RedTempus/ATMEGA328-OLED-Watch/image.png

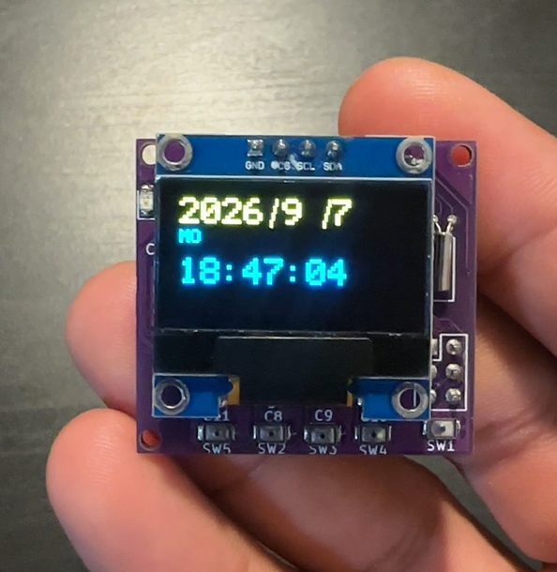
image.png
