RedTempus/ATMEGA328-OLED-Watch/watchPCB.JPG

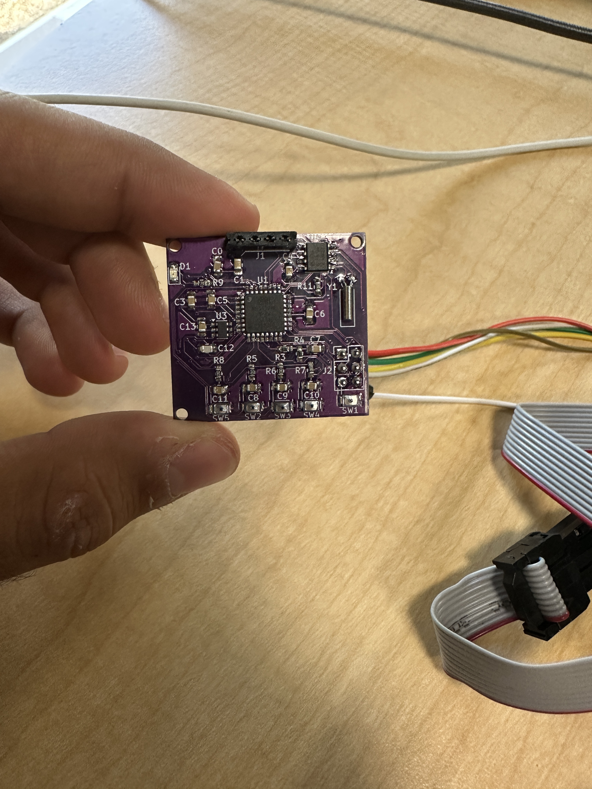
watchPCB.JPG
