RedTempus/ATMEGA328-OLED-Watch/README.md

# ATMEGA328-OLED-Watch
Building a reprogrammable watch around the ATMEGA328 microcontroller, with a OLED screen, and running it off of a CR2450 battery.
