RedTempus/ATMEGA328-OLED-Watch/BOM.xls

Sales Order #: | Web Order #: | PO Number: | Line No. | Order Date: | Order Status: | Mouser #: | Mfr. #: | Desc.: | Customer # | Order Qty. | Ext. (USD) | Price (USD) | Status | Date | Invoice # | Tariff: Price (USD) | Tariff: Ext. (USD)
280572248 | 39494410 | 39494410 | 1 | 12-Jun-26 | Complete | 556-ATMEGA328P-ANR | ATMEGA328P-ANR | 8-bit Microcontrollers - MCU 8-bit Microcontrollers - MCU AVR 32K FLSH 2K SRAM 1KB EE-20 MHZ 105C |  | 4 | $2.89 | $2.89 | 4 Shipped | 15-Jun-26 | 90869083
280572248 | 39494410 | 39494410 | 2 | 12-Jun-26 | Complete | 791-0805B104J250CT | 0805B104J250CT | Multilayer Ceramic Capacitors MLCC - SMD/SMT Multilayer Ceramic Capacitors MLCC - SMD/SMT 0805 MLCC X7R 0.1 uF, +/- 5% 25 V T&R GP |  | 100 | $0.021 | $0.021 | 100 Shipped | 15-Jun-26 | 90869083
280572248 | 39494410 | 39494410 | 3 | 12-Jun-26 | Complete | 859-LTST-C171KGKT | LTST-C171KGKT | Single Color LEDs Single Color LEDs Green Clear 571nm |  | 10 | $0.07 | $0.07 | 10 Shipped | 15-Jun-26 | 90869083 | $0.006 | $0.06
280572248 | 39494410 | 39494410 | 4 | 12-Jun-26 | Complete | 187-CL21A106KPFNNNG | CL21A106KPFNNNG | Multilayer Ceramic Capacitors MLCC - SMD/SMT Multilayer Ceramic Capacitors MLCC - SMD/SMT 10uF+/-10% 10V X5R 2 0805 |  | 25 | $0.04 | $0.04 | 25 Shipped | 15-Jun-26 | 90869083 | $0.003 | $0.08
280572248 | 39494410 | 39494410 | 5 | 12-Jun-26 | Complete | 80-C0805C102K9RACTU | C0805C102K9RACTU | Multilayer Ceramic Capacitors MLCC - SMD/SMT Multilayer Ceramic Capacitors MLCC - SMD/SMT 6.3V 0.001uF 10% X7R 0805 |  | 20 | $0.043 | $0.043 | 20 Shipped | 15-Jun-26 | 90869083 | $0.003 | $0.06
280572248 | 39494410 | 39494410 | 6 | 12-Jun-26 | Complete | 640-SWT7016006016SSA | SWT7016-006016SSA | Tactile Switches Tactile Switches Tactile Switch, SPST-NO, 3.0 x 2.0mm, Top act 0.6mm high, 160g, SMT, IP67 |  | 25 | $0.173 | $0.173 | 25 Shipped | 15-Jun-26 | 90869083 | $0.066 | $1.65
280572248 | 39494410 | 39494410 | 7 | 12-Jun-26 | Complete | 595-TPS22917DBVR | TPS22917DBVR | Power Switch ICs - Power Distribution Power Switch ICs - Power Distribution 5.5-V 2-A 80-mohm 10 -nA leakage load A A 595-TPS22917DBVT |  | 10 | $0.363 | $0.363 | 10 Shipped | 15-Jun-26 | 90869083
280572248 | 39494410 | 39494410 | 8 | 12-Jun-26 | Complete | 771-PCF85263AT/AJ | PCF85263AT/AJ | Real Time Clock Real Time Clock RTC IC with 400 kHz I2C interface featuring backup battery switch-over function in SO8 package. |  | 4 | $1.22 | $1.22 | 4 Shipped | 15-Jun-26 | 90869083
280572248 | 39494410 | 39494410 | 9 | 12-Jun-26 | Complete | 520-TFC2X6-X | ECS-.327-12.5-13X | Crystals Crystals 32.768KHz 12.5pF |  | 10 | $0.197 | $0.197 | 10 Shipped | 15-Jun-26 | 90869083 | $0.016 | $0.16
280572248 | 39494410 | 39494410 | 10 | 12-Jun-26 | Complete | 791-0805N201J101CT | 0805N201J101CT | Multilayer Ceramic Capacitors MLCC - SMD/SMT Multilayer Ceramic Capacitors MLCC - SMD/SMT 0805 MLCC NPO 200 pF, +/- 5% 100 V T&R GP |  | 10 | $0.061 | $0.061 | 10 Shipped | 15-Jun-26 | 90869083
280572248 | 39494410 | 39494410 | 11 | 12-Jun-26 | Complete | 667-ERJ-3EKF1004V | ERJ-3EKF1004V | Thick Film Resistors - SMD Thick Film Resistors - SMD 0603 1Mohms 1% Tol AEC-Q200 |  | 25 | $0.024 | $0.024 | 25 Shipped | 15-Jun-26 | 90869083 | $0.002 | $0.05
280572248 | 39494410 | 39494410 | 12 | 12-Jun-26 | Complete | 603-RC0603FR-10100KL | RC0603FR-10100KL | Thick Film Resistors - SMD Thick Film Resistors - SMD General Purpose Chip Resistor 0603, 100kOhms, 1%, 1/10W |  | 100 | $0.008 | $0.008 | 100 Shipped | 15-Jun-26 | 90869083 | $0.001 | $0.10
280572248 | 39494410 | 39494410 | 13 | 12-Jun-26 | Complete | 279-CRGCQ0603F10K | CRGCQ0603F10K | Thick Film Resistors - SMD Thick Film Resistors - SMD CRGCQ 0603 10K 1% SMD Resistor |  | 50 | $0.018 | $0.018 | 50 Shipped | 15-Jun-26 | 90869083
280572248 | 39494410 | 39494410 | 14 | 12-Jun-26 | Complete | 737-BH-109B-5 | BH-109B-5 | Coin Cell Battery Holders Coin Cell Battery Holders BATT RETAINER COIN 1/2CEL PC PIN |  | 4 | $0.57 | $0.57 | 4 Shipped | 15-Jun-26 | 90869083 | $0.143 | $0.57
