RedTempus/ATMEGA328-OLED-Watch/WatchMe.kicad_pcb

## KiCad design WatchMe.kicad_pcb (2026-08-28)

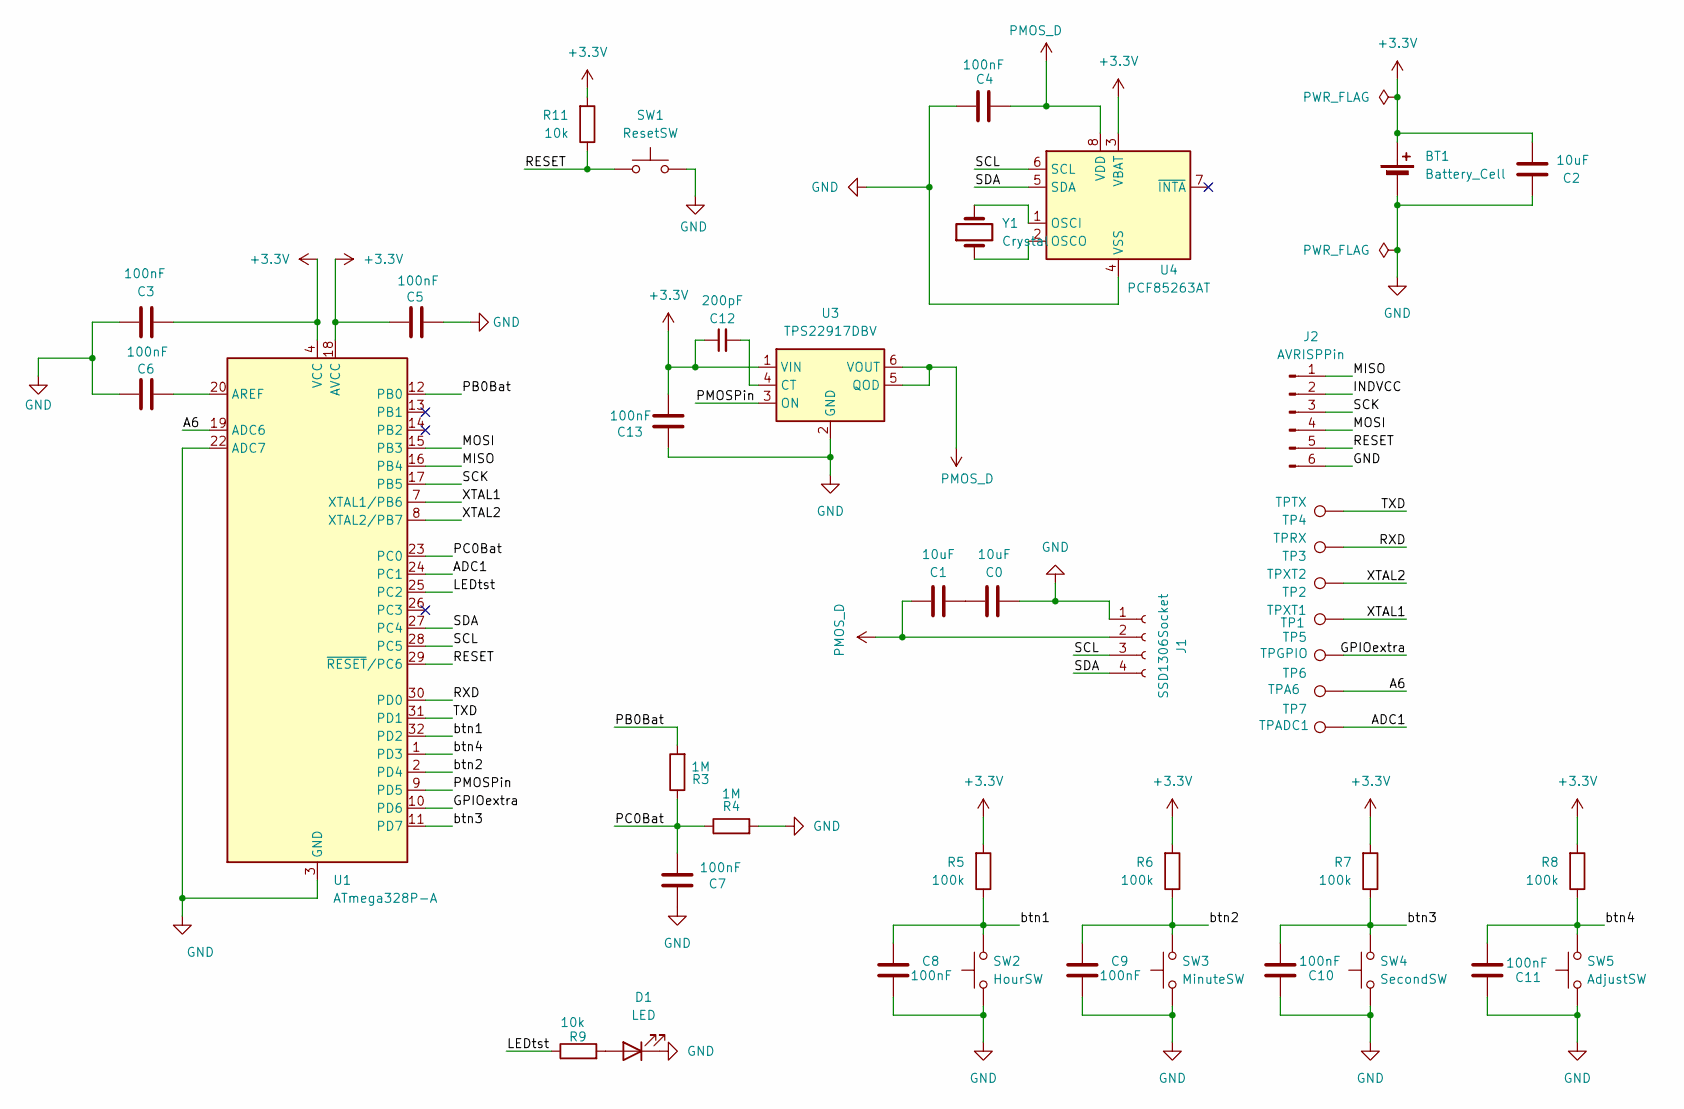
[picture p3: schematic WatchMe.kicad_sch]

Parts:
BT1: Battery_Cell; CR2450Holder
C0, C1, C2: 10uF; C_0805_2012Metric_Pad1.18x1.45mm_HandSolder
C3, C4, C5, C6, C7, C8, C9, C10, C11, C13: 100nF; C_0805_2012Metric_Pad1.18x1.45mm_HandSolder
C12: 200pF; C_0805_2012Metric_Pad1.18x1.45mm_HandSolder
D1: LED; LED_0805_2012Metric_Pad1.15x1.40mm_HandSolder
J1: SSD1306Socket
J2: AVRISPPin; PinHeader_2x03_P2.54mm_Vertical
R3, R4: 1M; R_0603_1608Metric_Pad0.98x0.95mm_HandSolder
R5, R6, R7, R8: 100k; R_0603_1608Metric_Pad0.98x0.95mm_HandSolder
R9, R11: 10k; R_0603_1608Metric_Pad0.98x0.95mm_HandSolder
SW1: ResetSW; SWT7016
SW2: HourSW; SWT7016
SW3: MinuteSW; SWT7016
SW4: SecondSW; SWT7016
SW5: AdjustSW; SWT7016
TP1: TPXT1; TestPoint_Pad_D2.0mm
TP2: TPXT2; TestPoint_Pad_D2.0mm
TP3: TPRX; TestPoint_Pad_D2.0mm
TP4: TPTX; TestPoint_Pad_D2.0mm
TP5: TPGPIO; TestPoint_Pad_D2.0mm
TP6: TPA6; TestPoint_Pad_D2.0mm
TP7: TPADC1; TestPoint_Pad_D2.0mm
U1: ATmega328P-A; TQFP-32_7x7mm_P0.8mm
U3: TPS22917DBV; SOT-23-6
U4: PCF85263AT; SOIC-8_3.9x4.9mm_P1.27mm
Y1: Crystal; Crystal_DS26_D2.0mm_L6.0mm_Horizontal

Connections:
+3.3V: BT1.1 (+), C2.1, C3.2, C5.2, C12.1, C13.2, R5.2, R6.2, R7.2, R8.2, R11.2, U1.4 (VCC), U1.6 (VCC), U1.18 (AVCC), U3.1 (VIN), U4.3 (VBAT)
/A6: TP6.1, U1.19 (ADC6)
/ADC1: TP7.1, U1.24 (PC1)
/GPIOextra: TP5.1, U1.10 (PD6)
/INDVCC: J2.2
/LEDtst: R9.1, U1.25 (PC2)
/MISO: J2.1, U1.16 (PB4)
/MOSI: J2.4, U1.15 (PB3)
/PB0Bat: R3.2, U1.12 (PB0)
/PC0Bat: C7.1, R3.1, R4.1, U1.23 (PC0)
/PMOSPin: U1.9 (PD5), U3.3 (ON)
/RESET: J2.5, R11.1, SW1.1, U1.29 (~RESET/PC6)
/RXD: TP3.1, U1.30 (PD0)
/SCK: J2.3, U1.17 (PB5)
/SCL: J1.3, U1.28 (PC5), U4.6 (SCL)
/SDA: J1.4, U1.27 (PC4), U4.5 (SDA)
/TXD: TP4.1, U1.31 (PD1)
/XTAL1: TP1.1, U1.7 (XTAL1/PB6)
/XTAL2: TP2.1, U1.8 (XTAL2/PB7)
/btn1: C8.1, R5.1, SW2.2, U1.32 (PD2)
/btn2: C9.1, R6.1, SW3.2, U1.2 (PD4)
/btn3: C10.1, R7.1, SW4.2, U1.11 (PD7)
/btn4: C11.1, R8.1, SW5.2, U1.1 (PD3)
GND: BT1.2 (-), C0.1, C2.2, C3.1, C4.2, C5.1, C6.1, C7.2, C8.2, C9.2, C10.2, C11.2, C13.1, D1.1 (K), J1.1, J2.6, R4.2, SW1.2, SW2.1, SW3.1, SW4.1, SW5.1, U1.3 (GND), U1.5 (GND), U1.21 (GND), U1.22 (ADC7), U3.2 (GND), U4.4 (VSS)
unnamed: C0.2, C1.1
unnamed: D1.2 (A), R9.2
unnamed: C6.2, U1.20 (AREF)
unnamed: C12.2, U3.4 (CT)
unnamed: U4.1 (OSCI), Y1.2
unnamed: U4.2 (OSCO), Y1.1
PMOS_D: C1.2, C4.1, J1.2, U3.5 (QOD), U3.6 (VOUT), U4.8 (VDD)

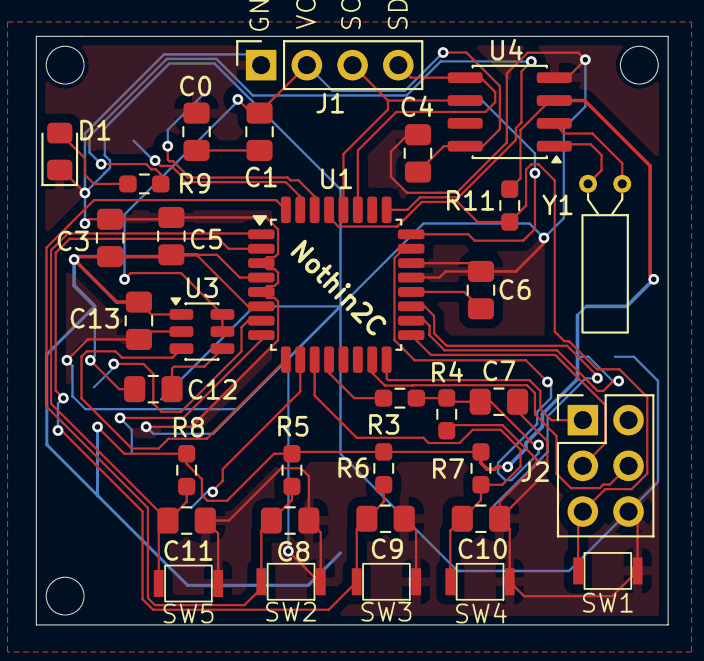
[picture p4: board WatchMe.kicad_pcb from above]

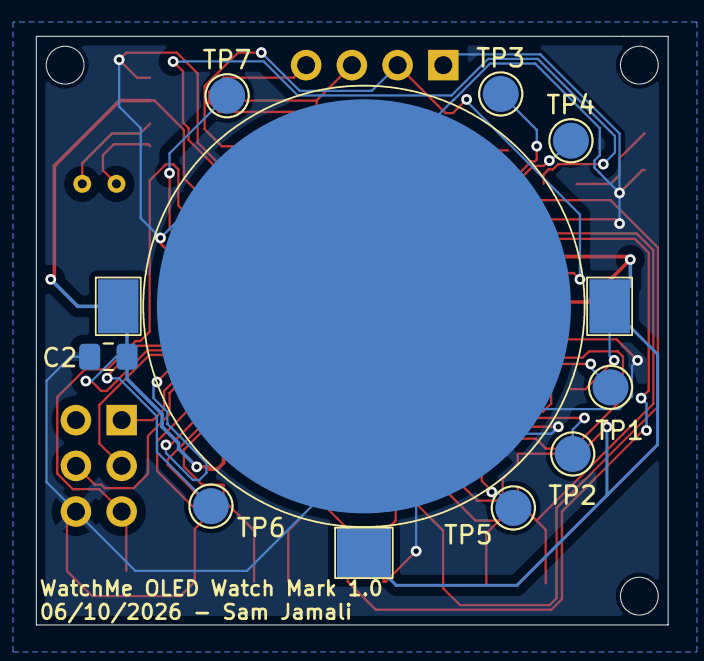
[picture p5: board WatchMe.kicad_pcb from below]

Board: 4 copper layers, 35.1 x 32.7 mm, 42 parts (9 on the bottom side), 30 nets.
