RedTempus/ATMEGA328-OLED-Watch/(commit log)

2026-08-28 Add files via upload
    PCB Schematic and Board
    [WatchMe.kicad_pcb, WatchMe.kicad_sch]
2026-09-08 Adding bill of materials
    [BOM.xls]
